Andre-Sanches/SISTEMA-DE-CONTROLE-PID/Estrutura Física/Projeto 3D_2.jpeg

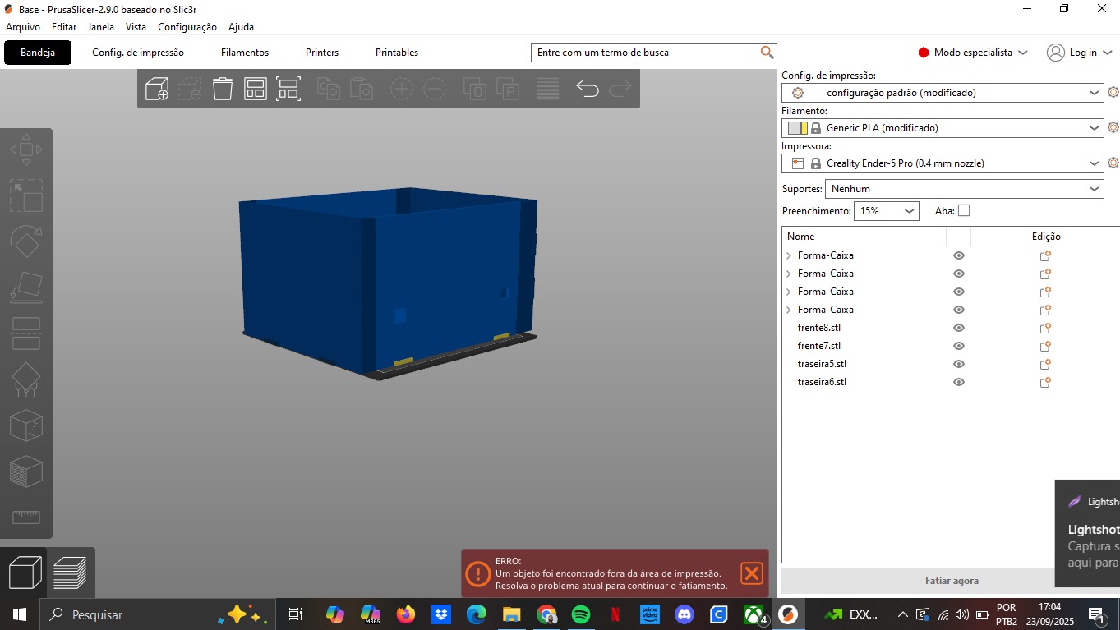
Estrutura Física/Projeto 3D_2.jpeg
