Andre-Sanches/SISTEMA-DE-CONTROLE-PID/README.md

# SISTEMA-DE-CONTROLE-PID
Trabalho de conclusão de curso realizado no curso de Engenharia Elétrica - FHO

⚠️ Restrições de Uso

Este material é fornecido "no estado em que se encontra" e destina-se unicamente a consulta. Qualquer uso comercial, seja direto ou indireto, é estritamente proibido sem autorização expressa do autor. Para outras finalidades ou solicitações de uso que não se enquadrem nas condições de uso acadêmico e não comercial, por favor, entre em contato com o autor.

✉️ Contato

André Rodrigues Sanches Seu Email: andrerodriguessanches@hotmail.com LinkedIn: www.linkedin.com/in/andre-rodrigues-sanches
