Andre-Sanches/SISTEMA-DE-CONTROLE-PID/Arduino/README.md

Arquivos para a montagem do projeto no Arduino
