Andre-Sanches/SISTEMA-DE-CONTROLE-PID/Arduino/Programa/README.md

Programa com função de controle de um motor DC 6V através de PID integrado com um display led e potênciometro com encoder.
