Andre-Sanches/SISTEMA-DE-CONTROLE-PID/Apresentação/README.md

Apresentação slides do trabalho de conclusão de curso.
