Andre-Sanches/SISTEMA-DE-CONTROLE-PID/Téorica/README.md

Trabalho de conclusão de curso parte escrita.
