Andre-Sanches/SISTEMA-DE-CONTROLE-PID/Arduino/Serial Plotter/Controlador P/Kp = 1.00/Setpoint - Posicao atual.PNG

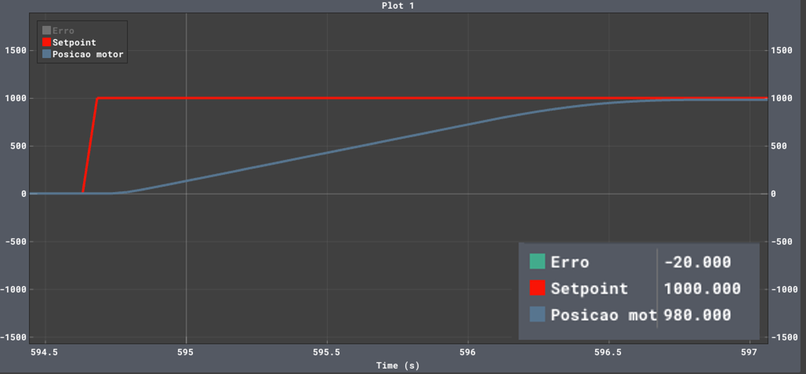
Arduino/Serial Plotter/Controlador P/Kp = 1.00/Setpoint - Posicao atual.PNG
