Andre-Sanches/SISTEMA-DE-CONTROLE-PID/Arduino/Serial Plotter/Controlador PD/Kp = 1.00 Kd = 0.10/Imagens separadas/Setpoint - Posicao atual.PNG

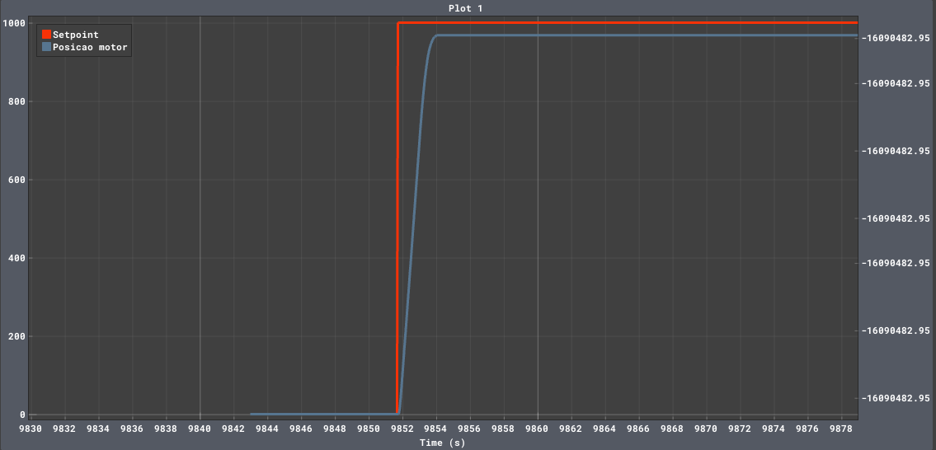
Arduino/Serial Plotter/Controlador PD/Kp = 1.00 Kd = 0.10/Imagens separadas/Setpoint - Posicao atual.PNG
