Andre-Sanches/SISTEMA-DE-CONTROLE-PID/Arduino/Serial Plotter/Controlador PD/Kp = 5.00 Kd = 0.20/Setpoint - Posicao atual.PNG

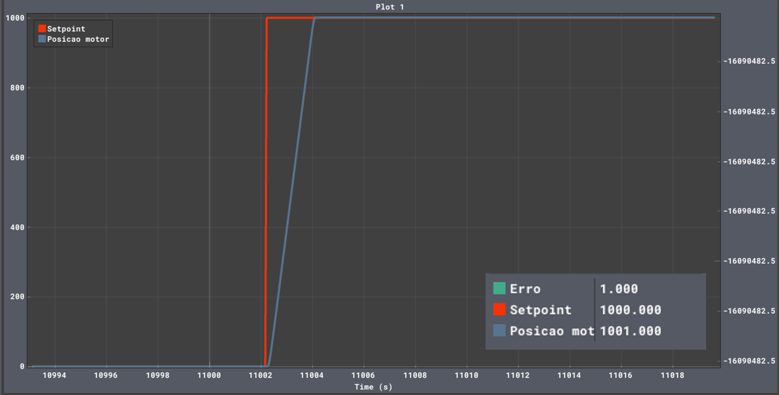
Arduino/Serial Plotter/Controlador PD/Kp = 5.00 Kd = 0.20/Setpoint - Posicao atual.PNG
