Andre-Sanches/SISTEMA-DE-CONTROLE-PID/Arduino/Serial Plotter/Controlador PI/Kp = 1.00 Ki = 0.10/Imagens separadas/Erro.PNG

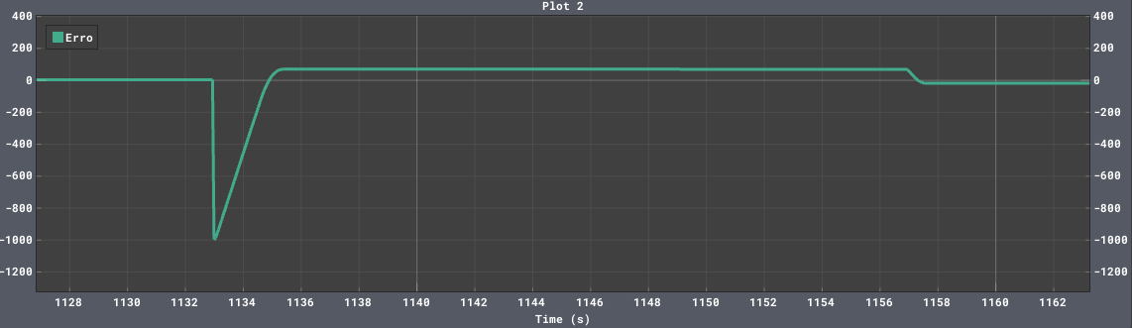
Arduino/Serial Plotter/Controlador PI/Kp = 1.00 Ki = 0.10/Imagens separadas/Erro.PNG
