Andre-Sanches/SISTEMA-DE-CONTROLE-PID/Arduino/Serial Plotter/Controlador PI/Kp = 1.00 Ki = 1.00/Erro.PNG

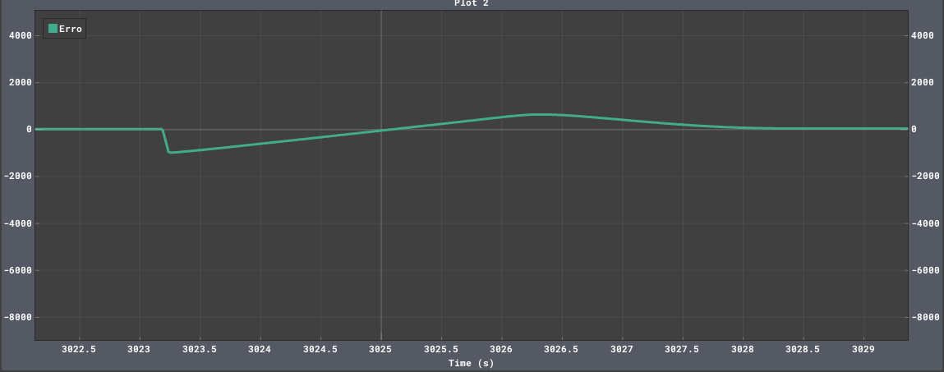
Arduino/Serial Plotter/Controlador PI/Kp = 1.00 Ki = 1.00/Erro.PNG
