Andre-Sanches/SISTEMA-DE-CONTROLE-PID/Arduino/Serial Plotter/Controlador PI/Kp = 5.00 Ki = 0.20/Setpoint - Posicao atual.PNG

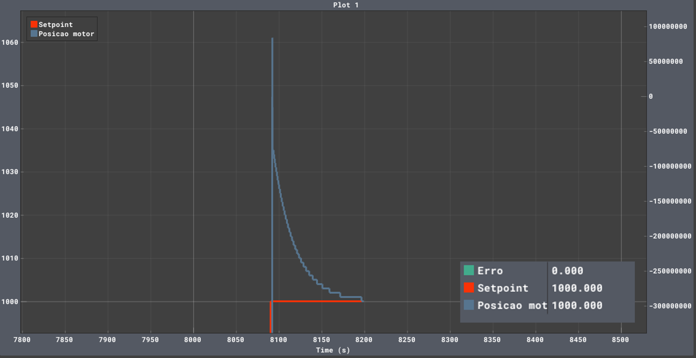
Arduino/Serial Plotter/Controlador PI/Kp = 5.00 Ki = 0.20/Setpoint - Posicao atual.PNG
