Andre-Sanches/SISTEMA-DE-CONTROLE-PID/Arduino/Serial Plotter/Controlador PI/Kp = 15.00 Ki = 0.50/Imagens separadas/Setpoint - Posicao atual (Inicial).PNG

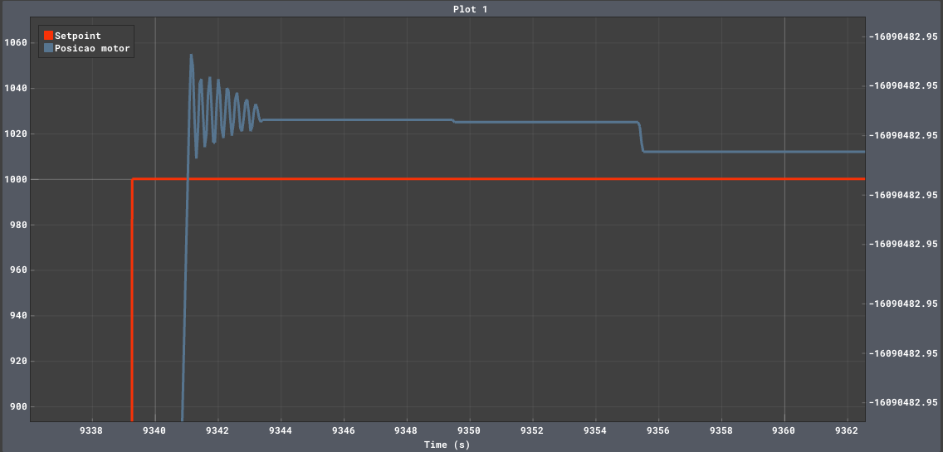
Arduino/Serial Plotter/Controlador PI/Kp = 15.00 Ki = 0.50/Imagens separadas/Setpoint - Posicao atual (Inicial).PNG
