Andre-Sanches/SISTEMA-DE-CONTROLE-PID/Arduino/Serial Plotter/Controlador PID/Kp = 1.00 Ki = 0.10 Kd = 0.50/Setpoint - Posicao atual.PNG

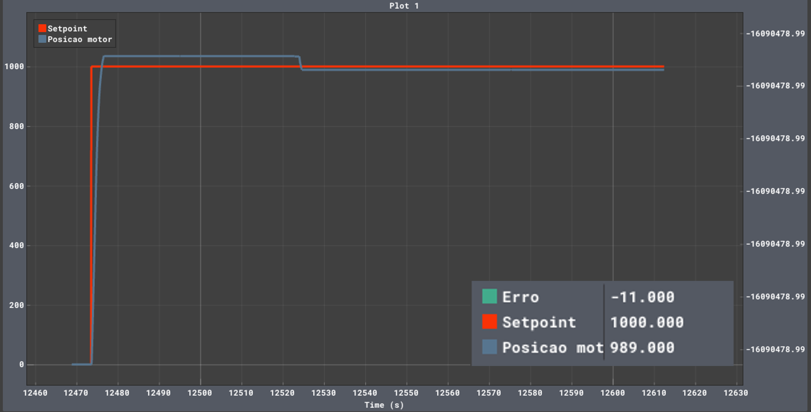
Arduino/Serial Plotter/Controlador PID/Kp = 1.00 Ki = 0.10 Kd = 0.50/Setpoint - Posicao atual.PNG
