Andre-Sanches/SISTEMA-DE-CONTROLE-PID/Arduino/Serial Plotter/Controlador PID/Kp = 1.00 Ki = 0.50 Kd = 0.50/Imagens separadas/Setpoint - Posicao atual (Inicial).PNG

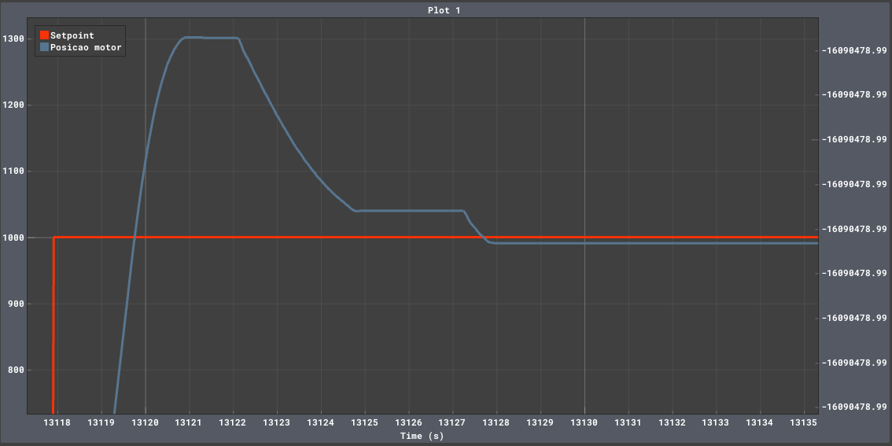
Arduino/Serial Plotter/Controlador PID/Kp = 1.00 Ki = 0.50 Kd = 0.50/Imagens separadas/Setpoint - Posicao atual (Inicial).PNG
