Andre-Sanches/SISTEMA-DE-CONTROLE-PID/Arduino/Serial Plotter/Controlador PID/Kp = 5.00 Ki = 0.50 Kd = 0.20/Imagens separadas/Setpoint - Posicao atual (Inicial).PNG

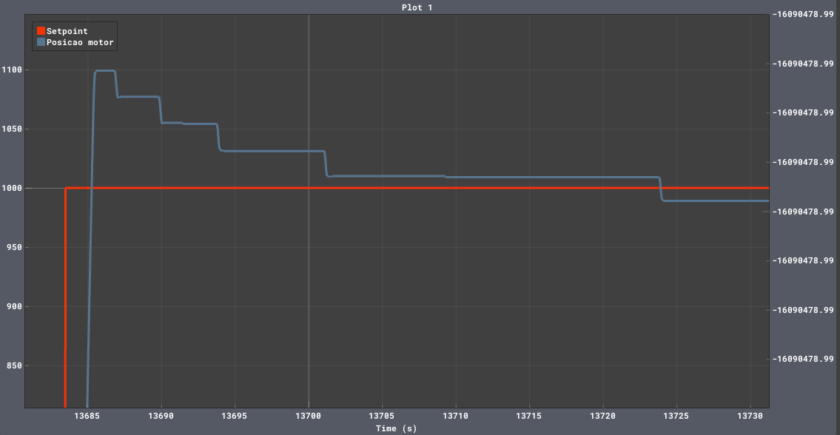
Arduino/Serial Plotter/Controlador PID/Kp = 5.00 Ki = 0.50 Kd = 0.20/Imagens separadas/Setpoint - Posicao atual (Inicial).PNG
