Andre-Sanches/SISTEMA-DE-CONTROLE-PID/Arduino/Serial Plotter/Controlador PID/Kp = 15.00 Ki = 0.20 Kd = 0.20/Imagens separadas/Setpoint - Posicao atual (Inicial).PNG

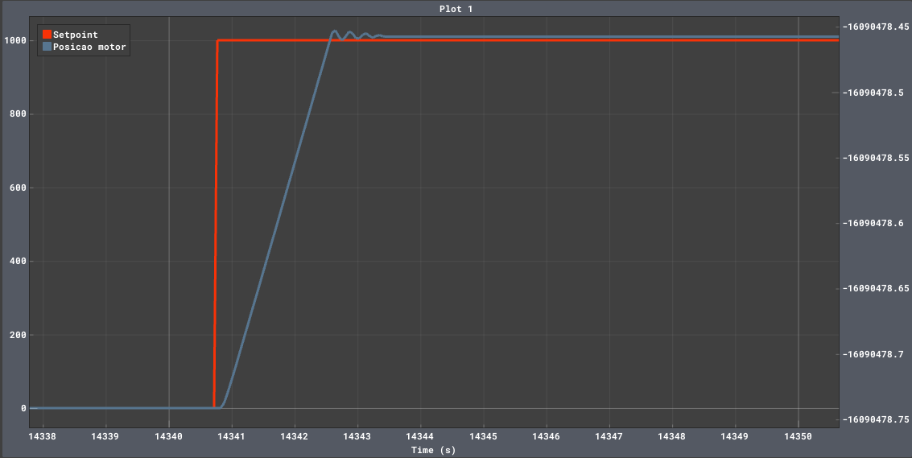
Arduino/Serial Plotter/Controlador PID/Kp = 15.00 Ki = 0.20 Kd = 0.20/Imagens separadas/Setpoint - Posicao atual (Inicial).PNG
