Andre-Sanches/SISTEMA-DE-CONTROLE-PID/Arduino/Serial Plotter/Controlador PID/Kp = 15.00 Ki = 0.50 Kd = 0.20/Setpoint - Posicao atual.PNG

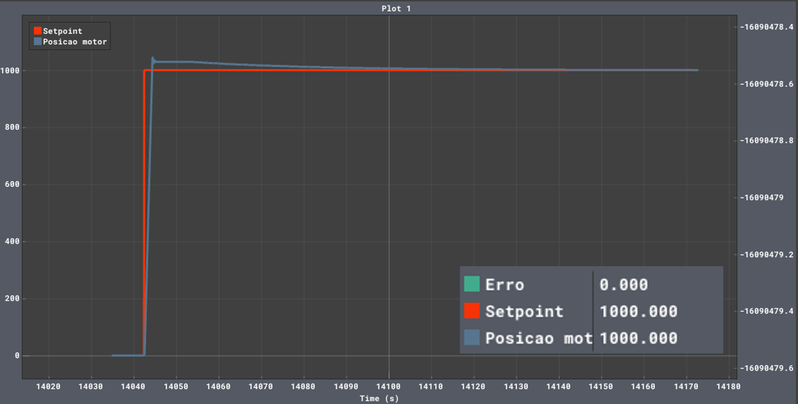
Arduino/Serial Plotter/Controlador PID/Kp = 15.00 Ki = 0.50 Kd = 0.20/Setpoint - Posicao atual.PNG
