Andre-Sanches/SISTEMA-DE-CONTROLE-PID/(commit log)

2025-10-21 Circuito eletrônico
    Circuito projetado no Cirkit Designer
2025-10-21 Circuito Eletrônico
2025-10-22 Controle PID.ino
2025-12-07 Update and rename TCC_V9.ino to Controle PID.ino
2025-12-08 Update Controle PID.ino
